adrieltap/Automated-Heated-Bridge-System-ECE445-Project/Notebooks/adriel/taparra2-Lab-Notebook.md

# 2/16/2025

* Met up as a group on a discord call from 3-5 PM. Talked about design choices, design review and how we are going to split work when presenting.
* Design modifications if proposal does not get accepted.
	* If more complexity is needed:
		* Add one more temperature sensor and one more moisture sensor.
			* We would then take the average between the two temperature sensors to get a more reliable reading and we could also do the same for the moisture sensor.
		* Design a UI app
			* This app would allow the user to turn "on" our system. Which means the system would start sensing the environment and heat up when necessary. 
			* It would also allow the user to turn it off
			* The app can also show the user how much money / resources they would have saved compared to if they kept the heater running the whole time.
* We also went over the placement and wiring of the sensors
	* Option 1 -> Place moisture sensor in the middle of the plate and the temperature sensor under the plate, there would be something to insulate the temperature sensor so it does not get incorrect reading if the heat is on.
		* We could ask machine shop to poke a hole between the plate to get our wires through
	* Option 2 -> Use ESP32 bluetooth and wifi features to send data to the MCU, this would require a separate battery for each sensors since they will be separated.
* Before our demo, I am planning on researching more about the ESP32, and our main event loop and how it will calculate if we would need to turn the heater on. 
	* How we decide to turn on the heat
		* If temperature < 0 Celsius AND moisture level is greater than the threshold
		* If temperature >= 0 Celsius OR moisture level is less than or equal to the threshold
	* Some pseudo code:
```
	if (temperature < 0°C AND moisture_level > threshold):
	    // Activate heating if freezing and moisture present
	    if (heating_status == OFF):
	        turn_on_heating()
	        heating_status = ON
	        log_event("Heating activated due to freezing and moisture detected.")
	else if (temperature >= 0°C OR moisture_level <= threshold):
	    // Deactivate heating if conditions are safe
	    if (heating_status == ON):
	        turn_off_heating()
	        heating_status = OFF
	        log_event("Heating deactivated - safe conditions.")
	else:
	    // Default case: system is in a neutral state, no action needed
	    log_event("System in neutral state - no heating needed.")
```
* ESP32
	* Temperature Sensor
	* Moisture Sensor
	* MOSFET-Based Switching
# 2/17/2025 - Design Review

* Met up again before our demo to prepare, talked about placement of moisture sensors and temperature sensors as well. Moisture sensor can be difficult since we would need to detect water on the whole entire plate.
	* Moisture sensor placements
		* Drainage system to detect water?
		* Flat Moisture sensors that can detect water.
* During Demo / Post Demo
	* Advice that we were told:
		* We will lose a lot of heat heating the surface because of air.
		* Look into how heated driveways work to see if we can derive it
		* Look into how bathroom heated floors work to see if we can also derive it as well
		* Fix block diagrams, have a legend for different communication protocols. Have actual square boxes with its subsystem in smaller boxes
		* Fail safe option if there is too much ice and our system cannot catch up.
		* Look into the temperatures allowed for our peripherals and parts.
		* Placements of PCB, how much we will heat and how to scale it
# 2/19/2025 

*  Peer Reviewed GymHive Tracker group
*  Different parts to consider:
	* Water sensor:  https://www.amazon.com/dp/B0BXKMLB4D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
	* Rain Sensor: https://www.amazon.com/dp/B0CM6224T2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
* Goal for the end of this week is to figure out the exact parts to buy so we can start on our PCB design.
* Plan is to meet up on Friday to discuss with machine shop with how to approach the metal plate.
* 

# 2/23/2025

* Meeting with group to discuss what parts are needed 
* Our goal by the end of this meeting is to decide the parts we need so we can start creating the schematic for our PCB
* Goal on Thursday is to get our PCB Ready
* We need to have these parts here:

- User Interface
	- Button
	- Sensor LEDs
- Display? - difficult to have when demo or realistic situation
- Sensing Subsystem
	- Temperature Sensor x2
	- Humidity Sensor
- Control Subsystem
	- ESP32?
	- Mosfet switch
- Power Subsystem
	- Voltage Regulator
	- AC/DC Converter
- Will meet with machine shop guy tomorrow (Monday) 2-3 pm we will be free
	- Where to place temperature sensors
		- I think we have this figured out
	- Where to place moisture sensor
		- Conversation to ask to machine shop guy
	- What will our plate look like
	- Maybe what it could look like
# 2/24/2025

* In charge of UI and Control SubSystem
	* MCU
		* ESP32-WROOM-32 has wireless capabilties just for future implementation
	* Mosfet Switch
		* IRLZ44NPBF
			* Vds = 55V
				* **VDS_{DS}DS** stands for **Drain-to-Source Voltage**. It is the maximum voltage that can be applied between the **drain (D)** and **source (S)** terminals of the MOSFET **before breakdown occurs**.
			* Id (at Vgs=-10V) = 47 A
				* - **What it means**: The maximum current the MOSFET can safely carry from **drain to source**.
				- **Why it matters**: If your circuit requires **20A**, you need a MOSFET with **ID_DD > 20A** to avoid overheating.
	- Questions
		- We need to figure out how much current / power is needed to heat up the plate before the PCB so we know which peripherals to pick in a power subsystem.
			- Size of the plate
		- How much heat will our MOSFET generate and will we need heat sinks for that?
			- Heatsinks?
		- Moisture sensor placement
		-  Stainless steel or Aluminimum
		- What heat cartridge to use
		- How realistic should this be?
	- Brainstorm
		- Railing on the bridge to place temperature sensor
		- Temperature Sensor at the bottom above the heat cartridges
## Notes from Talk with Gregg in Machine Shop

Types of metals available in machine shop:
* 60/61 aluminum
* Stainless steel

Dimensions:
* Range of thickness for stainless steel - 1 and a half to 3 mm. 1/16 of an inch and or 1/8th
* 2 to 1 width to length. 12 inch long 6 inch width
	- Heat cartridges and how much heat
	- 10 inch length, 5 inch width, 1/8 inch  
	- Metal type - steel
	- Thermal paste
- We can use this volume and type of material to get the mass of the metal

Thermocouple - measures what it touches

# 2/25/25 to 2/26/25
## Notes / Thoughts while drawing schematic for the ESP32

* ESP32-WROOM-32
	* Datasheet: https://www.espressif.com/sites/default/files/documentation/esp32-wroom-32_datasheet_en.pdf
	* Programming: https://docs.espressif.com/projects/esp-idf/en/latest/esp32/get-started/index.html
	* Vdd range: Min: 3.0V, Typical: 3.3V, Max: 3.6V
	* Operating Temperature -40 C to 85 C
* Power will be 3.3 V
* Which pins are necessary to program the ESP32?
* Maybe for breadboard demo we can get the breakout board to test our software to show our UI?
	* Ordered this for prototype and testing: https://www.amazon.com/ESP-WROOM-32-Development-Microcontroller-Integrated-Compatible/dp/B08D5ZD528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
* 
* Pins needed for 2x Temperature Sensor:
	* Part Number DS18B20
		* Datasheet: https://www.analog.com/media/en/technical-documentation/data-sheets/DS18B20.pdf
		* Water Proof
		* 1 Pin Interface
		* Supply Voltage
			* 3.0 Min
			* 5.5 Max V
	* PIN for Temp1 -> IO17
	* PIN for Temp2 -> IO19 
* Pins needed for 1x Moisture Sensor
	* PINXXX
* Voltage Regulator
* Still need to figure out which pins are necessary for flashing / programming
	* Good reddit page flashing / programming the MCU
		* https://www.reddit.com/r/esp32/comments/ovkp96/how_to_flash_raw_esp32_board/
	* Good reddit page for example schematic
		* https://www.reddit.com/r/esp32/comments/13t4cf2/i_am_making_board_with_esp32_wroom32d_do_i_have/
	* Source for schematic
		* https://espressif-docs.readthedocs-hosted.com/projects/esp-idf/en/latest/hw-reference/index.html
* RC Circuit for Time Delay
	* According to page 19 of ESP32 data sheet, this is needed to ensure the power supply to the ESP-32 during power-up
* Things to add for UI
	* Emergency Reset switch or button maybe?
	* LEDs that would give user info:
		* PCB is powered on
		* Indicator that TemperatureAir goes below/above threshold
		* Indicator that TemperatureSurface goes below/above threshold
		* Indicator that MoistureSensor goes below/above threshold
* Button
	* Make sure the button is open circuit if not pressed
# 2/26/2025

* TA was sick, but meet over zoom to discuss questions
	* We can use the dev board during breadboard demo
	* PCB review is optional
	* Order parts through TA to get reimbursed

# 2/27/2025

* Worked on PCB schematic today, need to do this tomorrow:
	* ADD LED to indicate there is power to PCB
		* Add LED for ON for the sensors?
		* Other LED indicators?
	* ADD test points
