adrieltap/Automated-Heated-Bridge-System-ECE445-Project/Group52HeatedBridge-resized/Group52HeatedBridge.kicad_pcb

## KiCad design Group52HeatedBridge-resized/Group52HeatedBridge.kicad_pcb (2025-03-03)

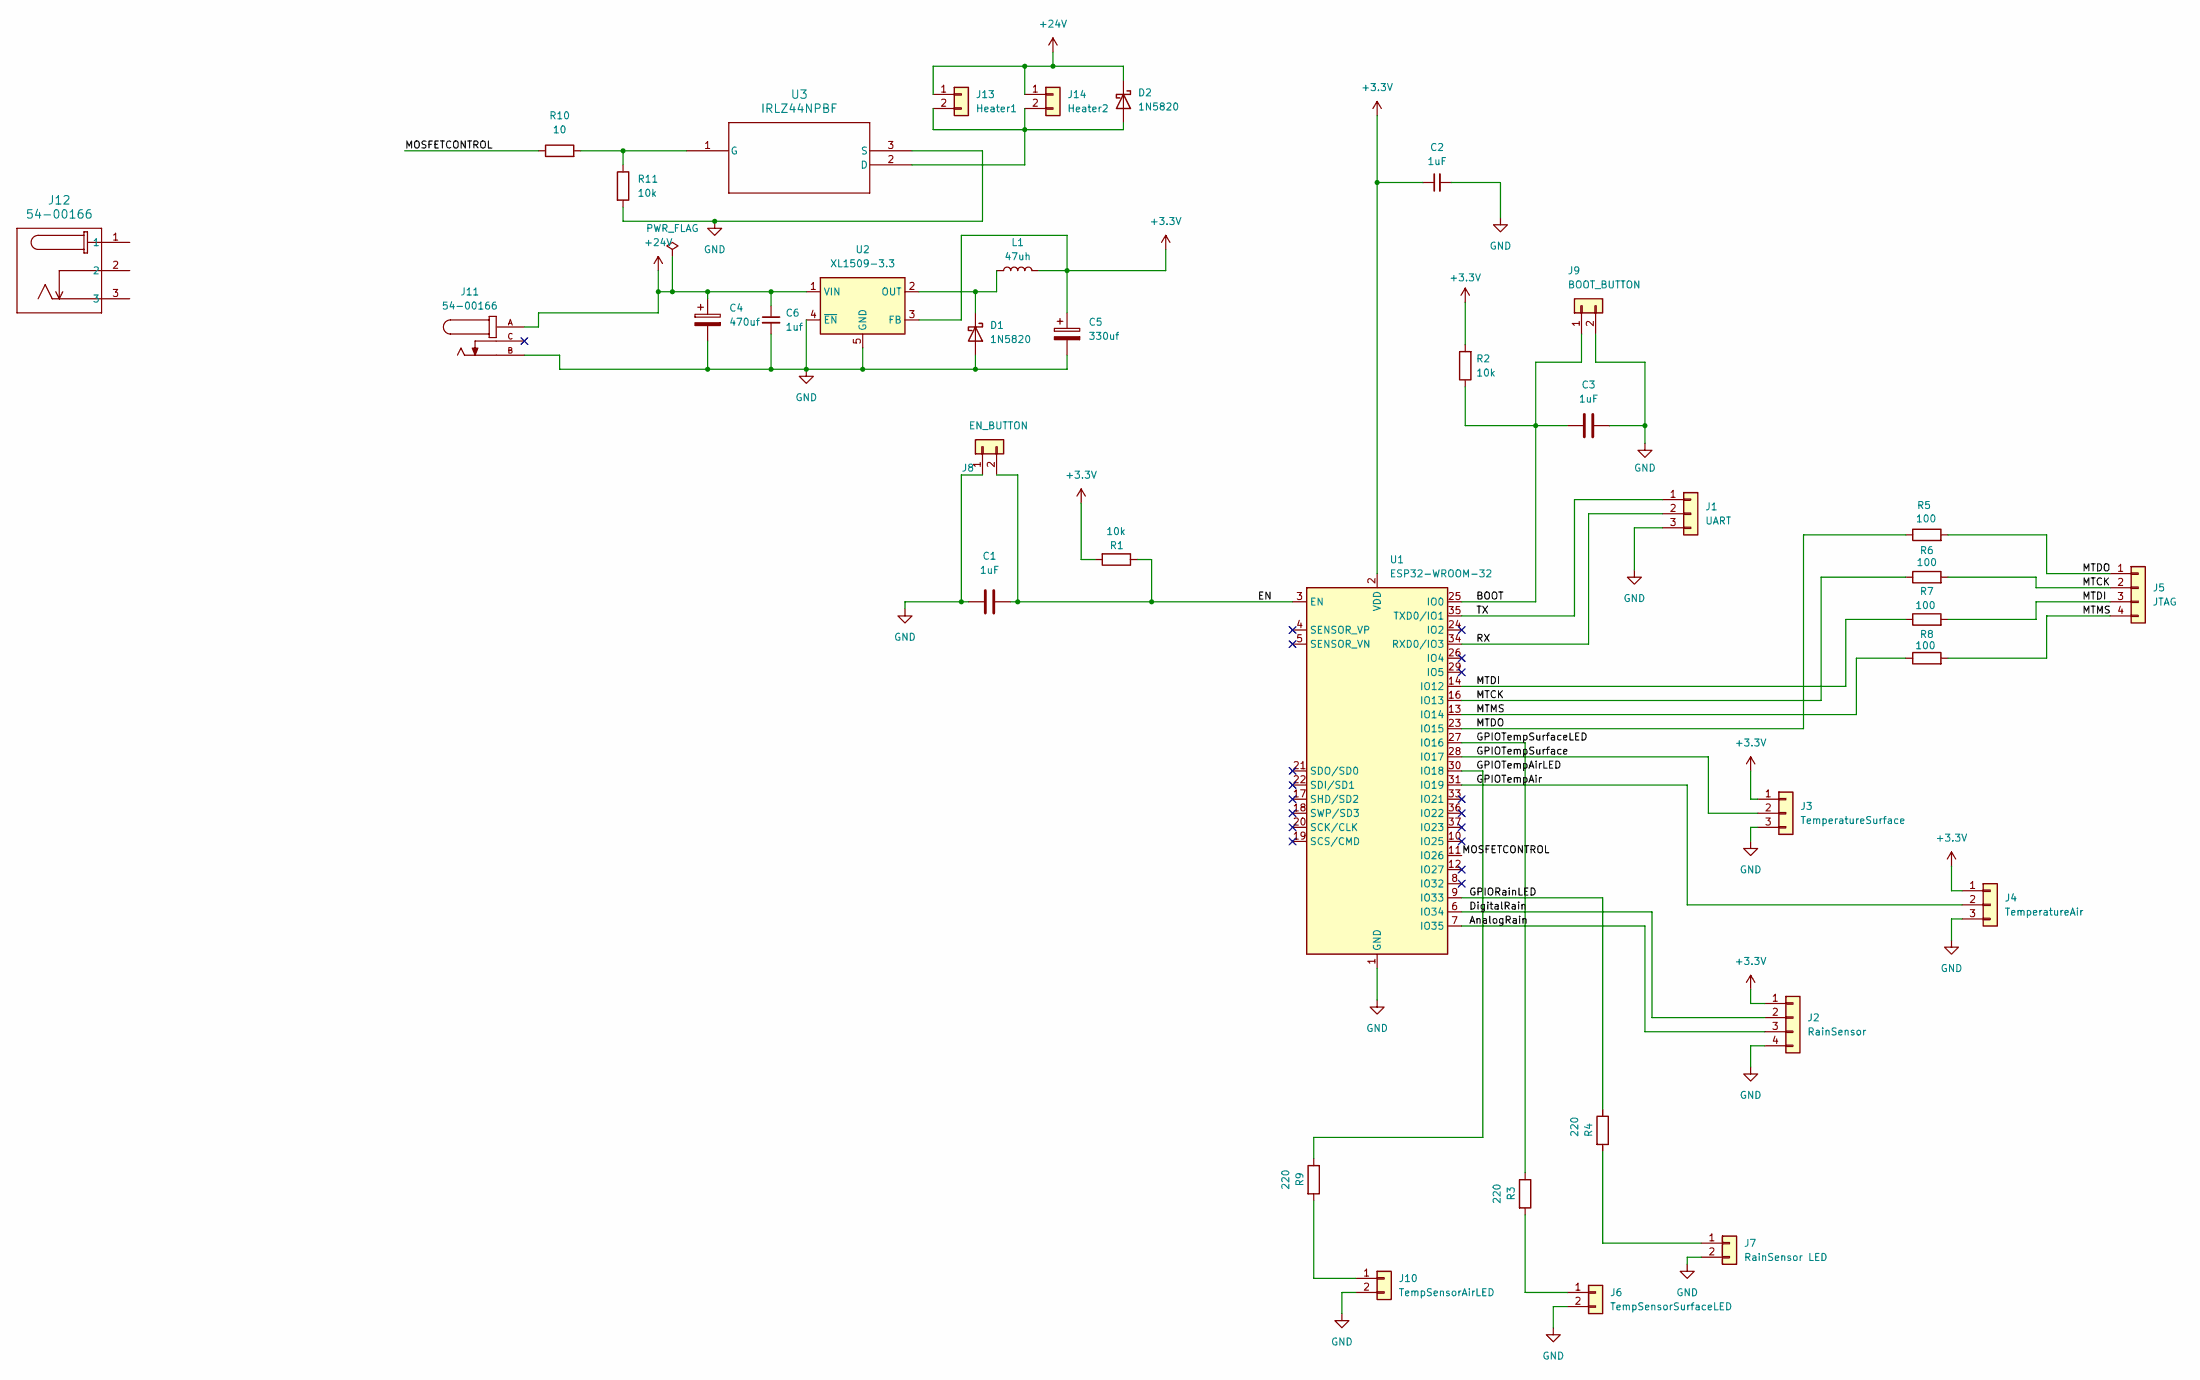
[picture p2: schematic Group52HeatedBridge.kicad_sch]

Parts:
C1, C2, C3: 1uF; C_0805_2012Metric_Pad1.18x1.45mm_HandSolder
C4: 470uf; C_0805_2012Metric_Pad1.18x1.45mm_HandSolder
C5: 330uf; C_0805_2012Metric_Pad1.18x1.45mm_HandSolder
C6: 1uf; C_0805_2012Metric_Pad1.18x1.45mm_HandSolder
D1, D2: 1N5820; D_DO-201AD_P3.81mm_Vertical_KathodeUp
J1: UART; Molex_KK-254_AE-6410-03A_1x03_P2.54mm_Vertical
J2: RainSensor; Molex_KK-254_AE-6410-04A_1x04_P2.54mm_Vertical
J3: TemperatureSurface; Molex_KK-254_AE-6410-03A_1x03_P2.54mm_Vertical
J4: TemperatureAir; Molex_KK-254_AE-6410-03A_1x03_P2.54mm_Vertical
J5: JTAG; Molex_KK-254_AE-6410-04A_1x04_P2.54mm_Vertical
J6: TempSensorSurfaceLED; Molex_KK-254_AE-6410-02A_1x02_P2.54mm_Vertical
J7: RainSensor LED; Molex_KK-254_AE-6410-02A_1x02_P2.54mm_Vertical
J8: EN_BUTTON; Molex_KK-254_AE-6410-02A_1x02_P2.54mm_Vertical
J9: BOOT_BUTTON; Molex_KK-254_AE-6410-02A_1x02_P2.54mm_Vertical
J10: TempSensorAirLED; Molex_KK-254_AE-6410-02A_1x02_P2.54mm_Vertical
J11: 54-00166; TENSILITY_54-00166; PARTREV A
J12: 54-00166; TENSILITY_54-00166
J13: Heater1; Molex_KK-254_AE-6410-02A_1x02_P2.54mm_Vertical
J14: Heater2; Molex_KK-254_AE-6410-02A_1x02_P2.54mm_Vertical
L1: 47uh; L_0805_2012Metric_Pad1.15x1.40mm_HandSolder
R1, R2, R11: 10k; R_0805_2012Metric_Pad1.20x1.40mm_HandSolder
R3, R4, R9: 220; R_0805_2012Metric_Pad1.20x1.40mm_HandSolder
R5, R6, R7, R8: 100; R_0805_2012Metric_Pad1.20x1.40mm_HandSolder
R10: 10; R_0805_2012Metric_Pad1.20x1.40mm_HandSolder
U1: ESP32-WROOM-32
U2: XL1509-3.3; SOIC-8_3.9x4.9mm_P1.27mm
U3: IRLZ44NPBF; PG-TO220-3_INF

Connections:
+3.3V: C2.1, C5.1, J2.1, J3.1, J4.1, L1.2, R1.2, R2.2, U1.2 (VDD), U2.3 (FB)
+24V: C4.1, C6.1, D2.1 (K), J11.A, J13.1, J14.1, U2.1 (VIN)
/AnalogRain: J2.3, U1.7 (IO35)
/BOOT: C3.1, J9.1, R2.1, U1.25 (IO0)
/DigitalRain: J2.2, U1.6 (IO34)
/EN: C1.2, J8.2, R1.1, U1.3 (EN)
/GPIORainLED: R4.1, U1.9 (IO33)
/GPIOTempAir: J4.2, U1.31 (IO19)
/GPIOTempAirLED: R9.1, U1.30 (IO18)
/GPIOTempSurface: J3.2, U1.28 (IO17)
/GPIOTempSurfaceLED: R3.1, U1.27 (IO16)
/MOSFETCONTROL: R10.1, U1.11 (IO26)
/MTCK: J5.2, R6.1, R6.2, U1.16 (IO13)
/MTDI: J5.3, R7.1, R7.2, U1.14 (IO12)
/MTDO: J5.1, R5.1, R5.2, U1.23 (IO15)
/MTMS: J5.4, R8.1, R8.2, U1.13 (IO14)
/RX: J1.2, U1.34 (RXD0/IO3)
/TX: J1.1, U1.35 (TXD0/IO1)
GND: C1.1, C2.2, C3.2, C4.2, C5.2, C6.2, D1.2 (A), J1.3, J2.4, J3.3, J4.3, J6.2, J7.2, J8.1, J9.2, J10.2, J11.B, R11.2, U1.1 (GND), U1.15 (GND), U1.38 (GND), U1.39 (GND), U2.4 (~EN), U2.5 (GND), U2.6 (GND), U2.7 (GND), U2.8 (GND), U3.3 (S)
unnamed: D1.1 (K), L1.1, U2.2 (OUT)
unnamed: D2.2 (A), J13.2, J14.2, U3.2 (D)
unnamed: J6.1, R3.2
unnamed: J7.1, R4.2
unnamed: J10.1, R9.2
unnamed: R10.2, R11.1, U3.1 (G)

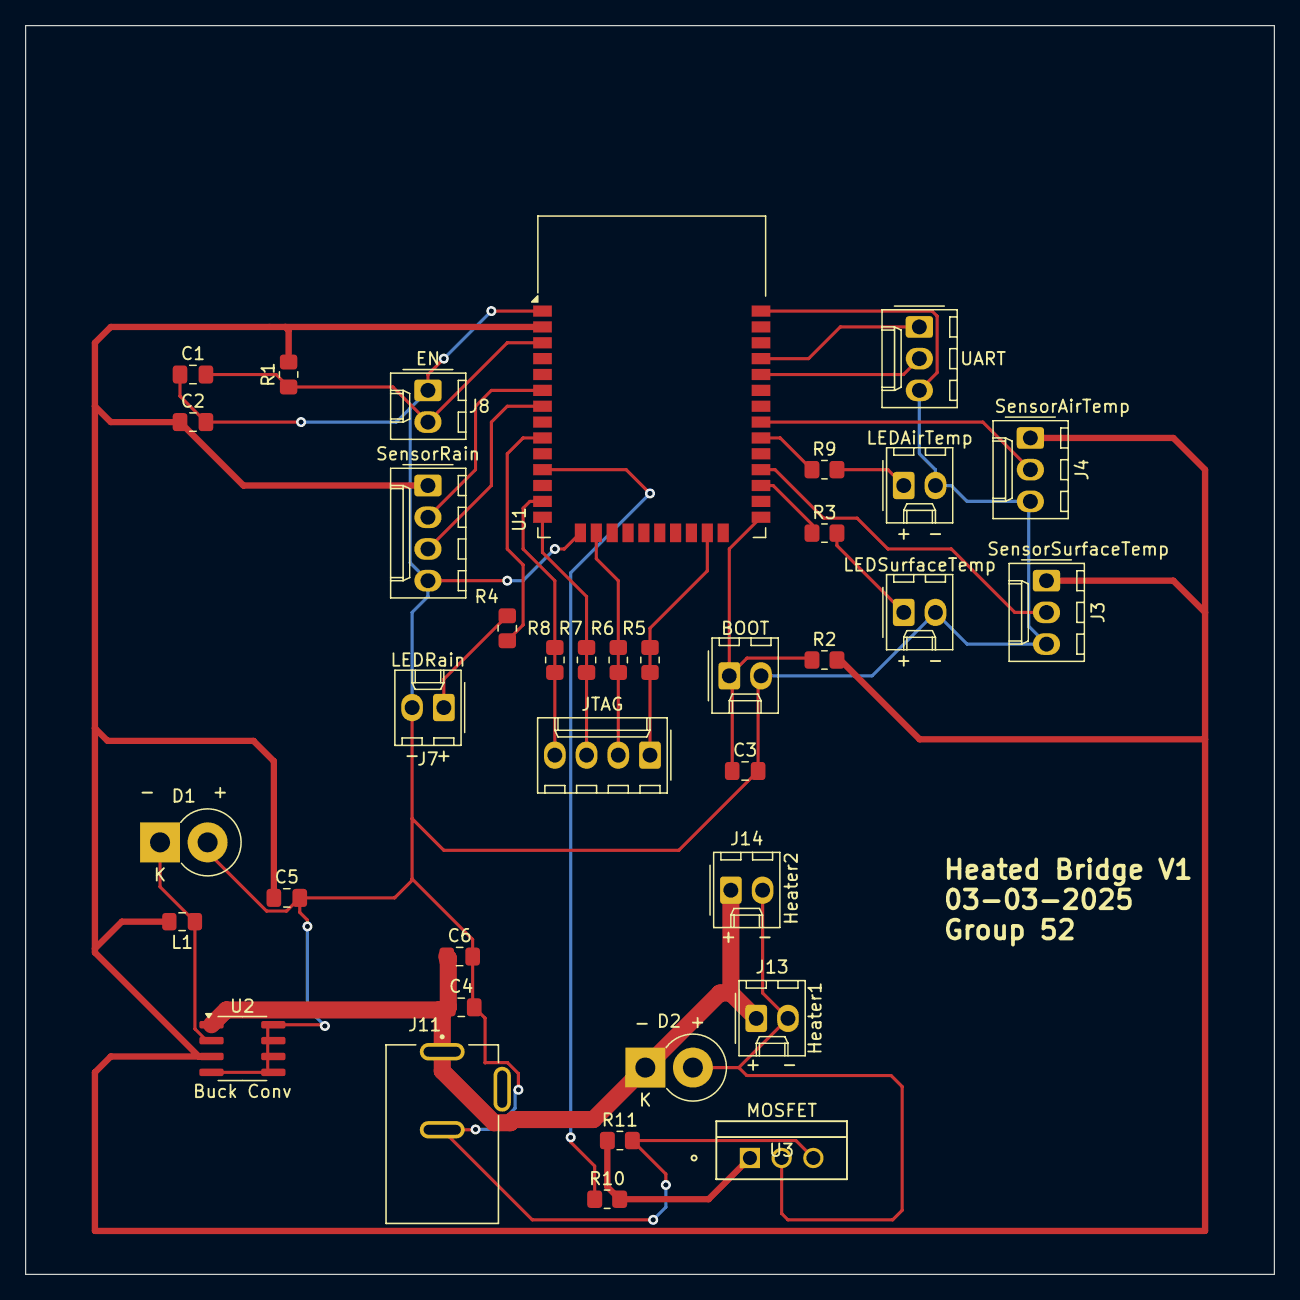
[picture p3: board Group52HeatedBridge.kicad_pcb from above]

Board: 2 copper layers, 100.0 x 100.0 mm, 36 parts (0 on the bottom side), 25 nets.
