adrieltap/Automated-Heated-Bridge-System-ECE445-Project/(commit log)

2025-02-24 switching to a digital notebook :"
2025-02-24 parts for power supply
2025-02-26 added schematic
2025-02-26 added deleted schematic
    [Group52HeatedBridge.kicad_pcb, Group52HeatedBridge.kicad_sch]
2025-02-26 added connectors and researched new temp sensor that is waterproof and easy to interface with
    [Group52HeatedBridge.kicad_sch]
2025-02-28 updated schematic
    [Group52HeatedBridge.kicad_sch]
2025-02-28 grid size update fix
    [Group52HeatedBridge.kicad_pcb, Group52HeatedBridge.kicad_sch]
2025-02-28 Added IO and rain sensor to schematic
    [Group52HeatedBridge.kicad_pcb, Group52HeatedBridge.kicad_sch]
2025-02-28 scematic passes DRC except one error where we need to draw the actual physical border of our PCB, components are flipped tho
    [Group52HeatedBridge.kicad_pcb, Group52HeatedBridge.kicad_sch]
2025-02-28 added more labels for orientation
    [Group52HeatedBridge.kicad_pcb]
2025-03-02 power subsytem schematic
2025-03-02 power subsytem schematic - more chnages
    [Group52HeatedBridge.kicad_sch]
2025-03-02 power subsytem schematic push - second try
2025-03-03 power subsytem schematic push - second
    [Group52HeatedBridge.kicad_pcb, Group52HeatedBridge.kicad_sch]
2025-03-03 resized schematic and cleaned up
    [Group52HeatedBridge.kicad_pcb]
2025-03-03 B Revert "resized schematic and cleaned up"
    This reverts commit bab35e5b8986f5439bb45f55d315508e4487ff8d.
    reverted auto save file
    [Group52HeatedBridge.kicad_pcb, Group52HeatedBridge.kicad_sch]
2025-03-03 resize schematic
2025-03-03 pushing the resized version from adriel
    [Group52HeatedBridge.kicad_pcb, Group52HeatedBridge.kicad_sch]
2025-03-03 passes pcbway audit
    [Group52HeatedBridge-B_Cu.gbr, Group52HeatedBridge-B_Mask.gbr, Group52HeatedBridge-B_Paste.gbr, Group52HeatedBridge-B_Silkscreen.gbr, Group52HeatedBridge-Edge_Cuts.gbr, Group52HeatedBridge-F_Cu.gbr, Group52HeatedBridge-F_Mask.gbr, Group52HeatedBridge-F_Paste.gbr]
